justinkowski/flexrack-rails/README.md

# FlexRack Rail System
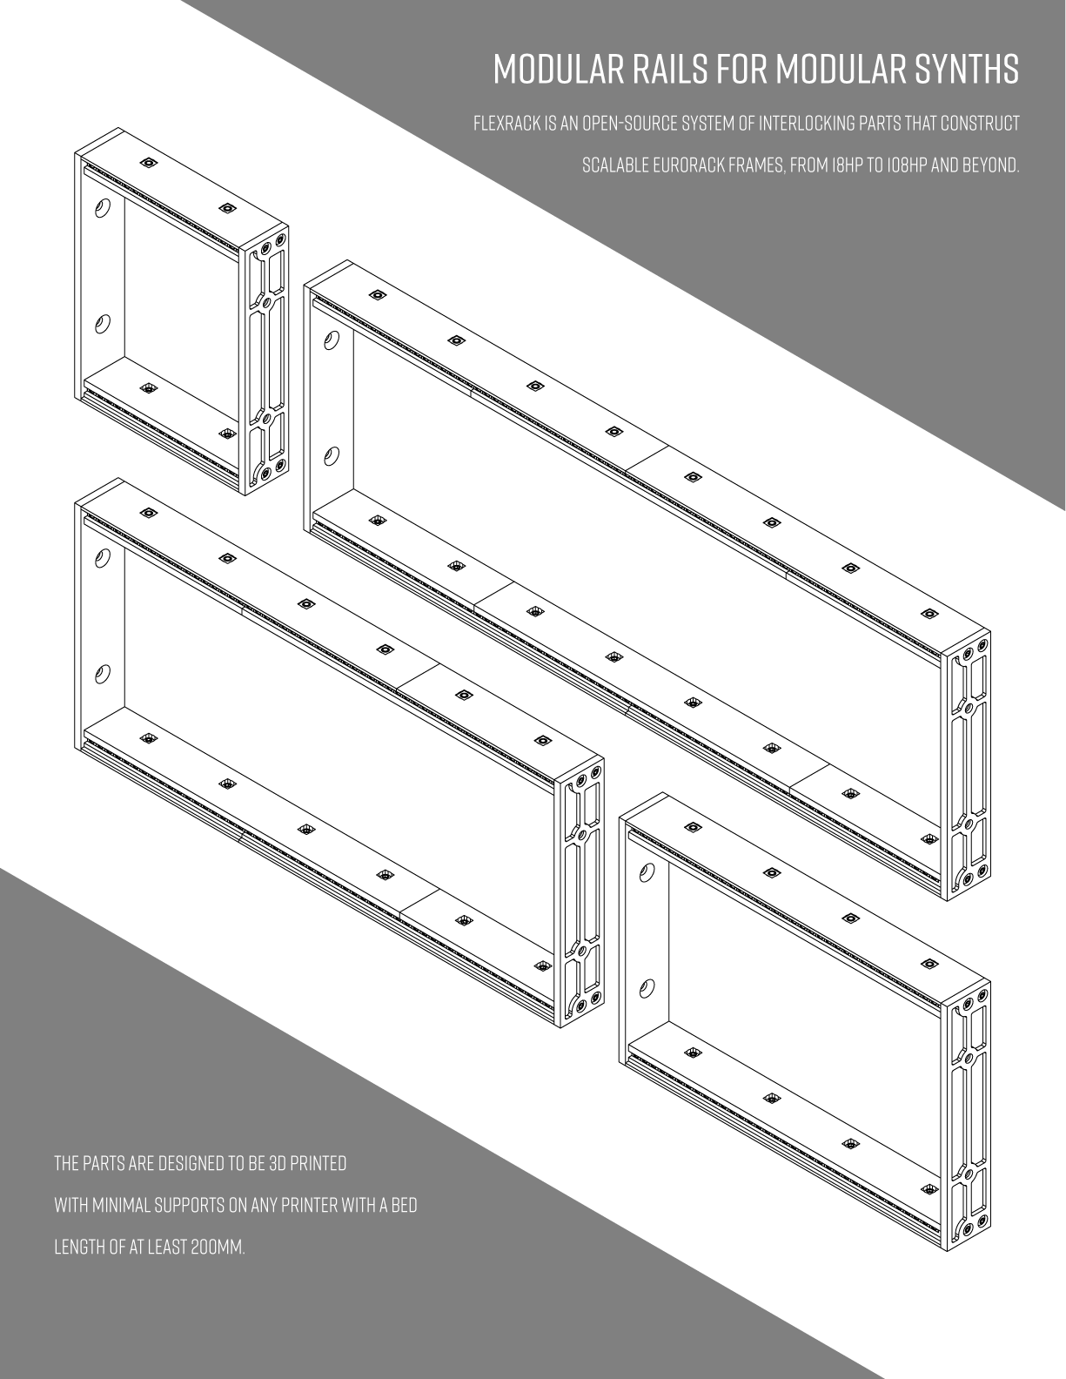
[picture p1: Images/01_intro.png]
FlexRack Intro

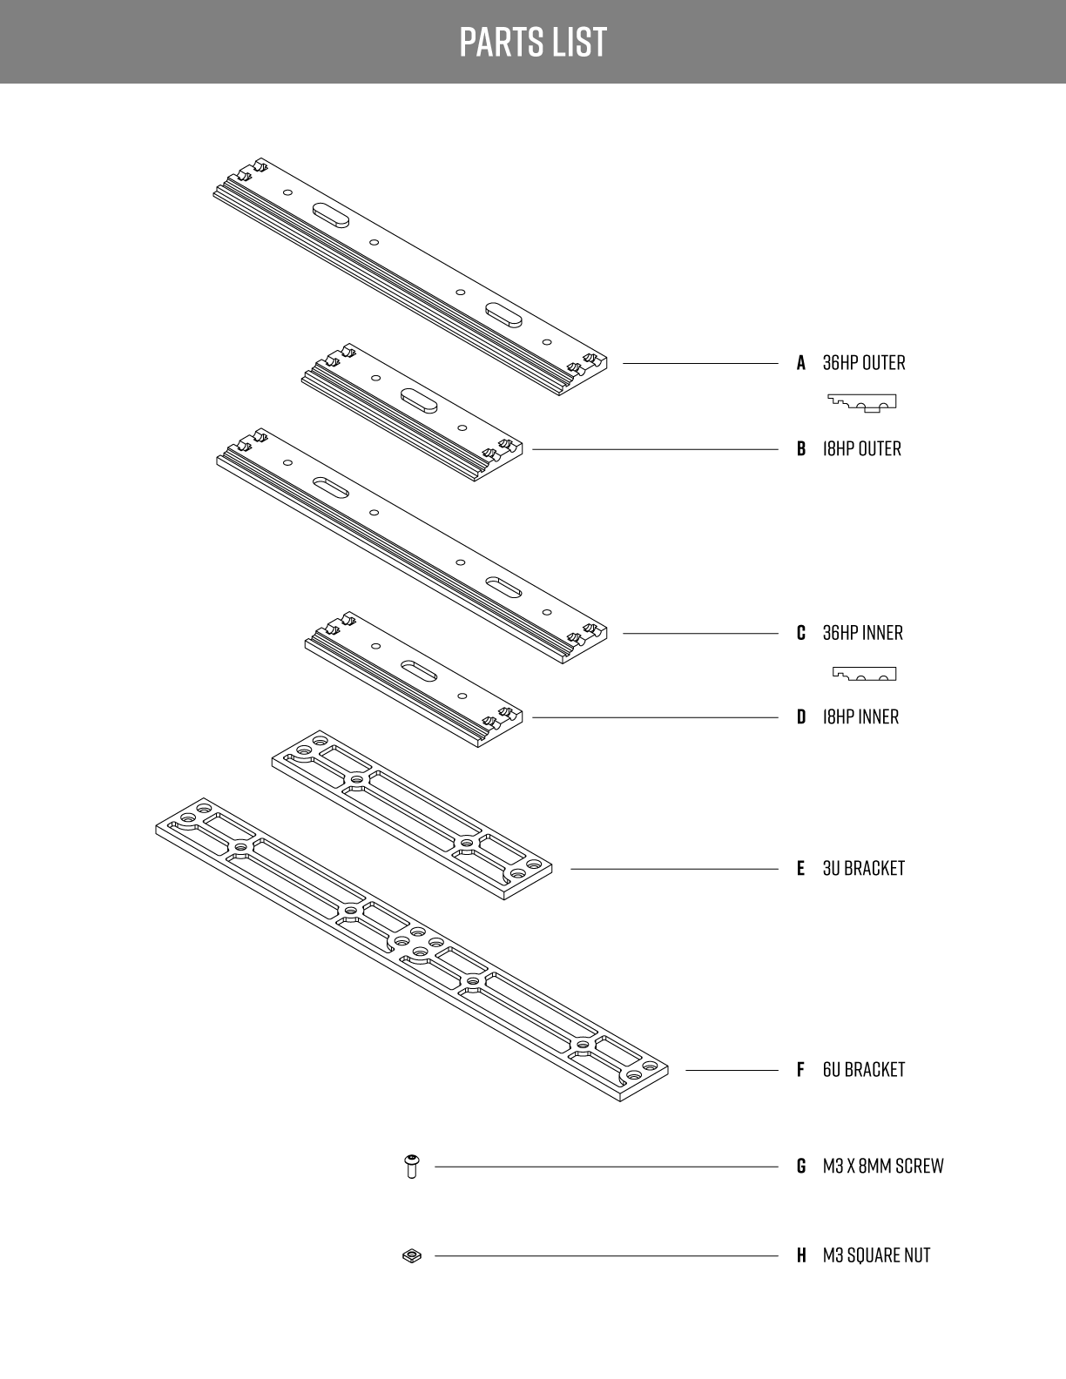
[picture p2: Images/02_parts.png]
Parts List

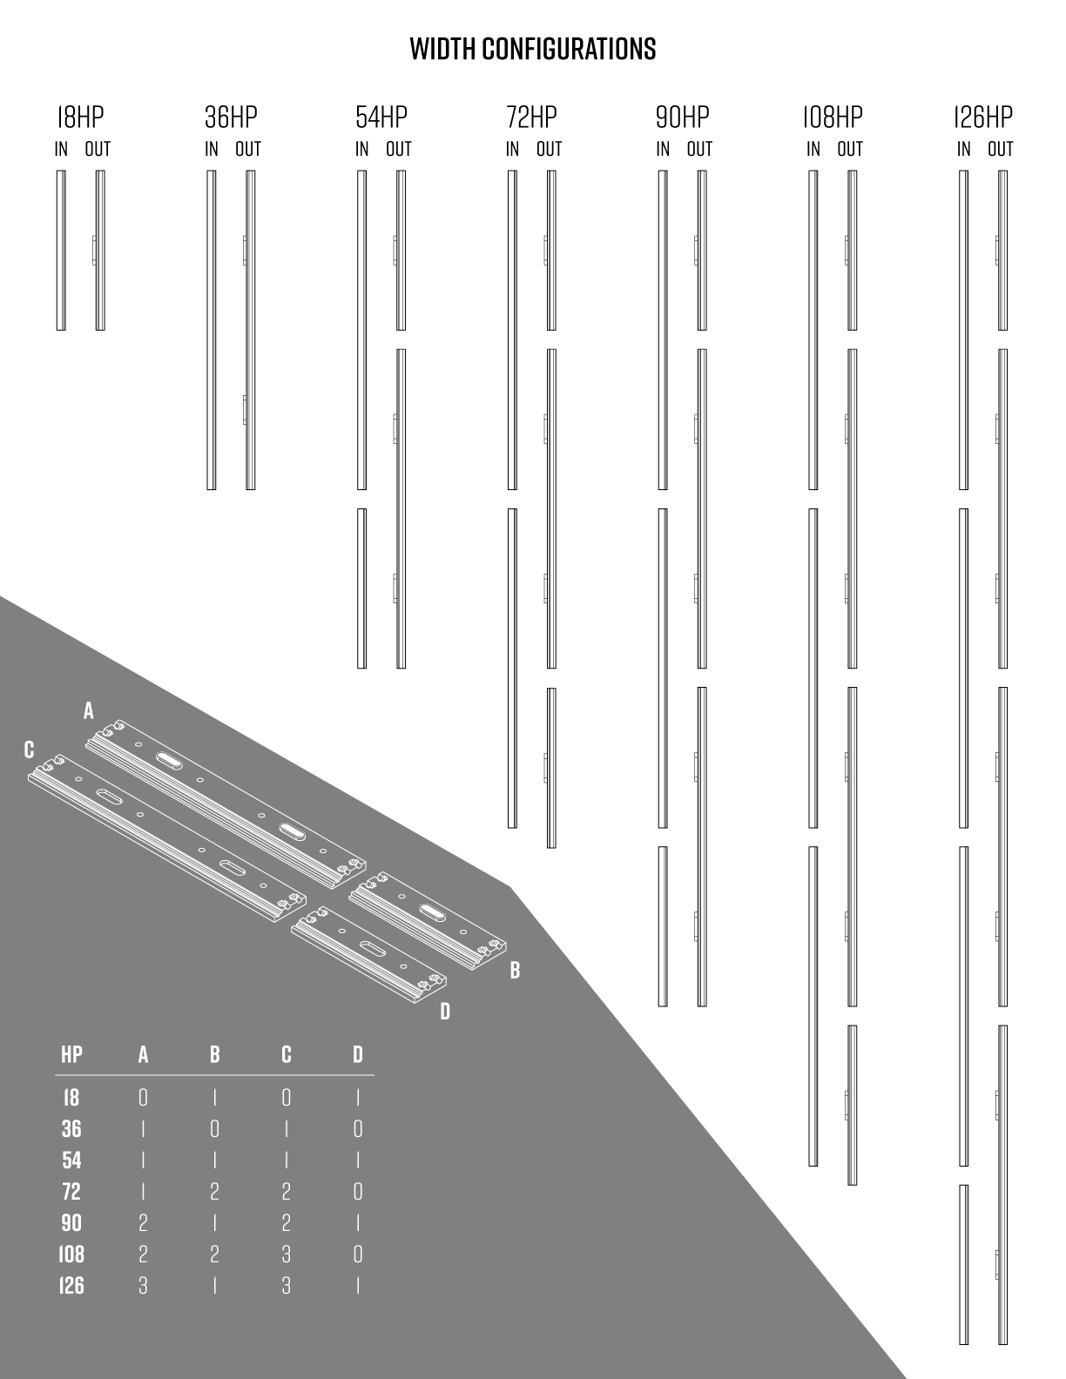
[picture p3: Images/03_width.png]
Width Configurations

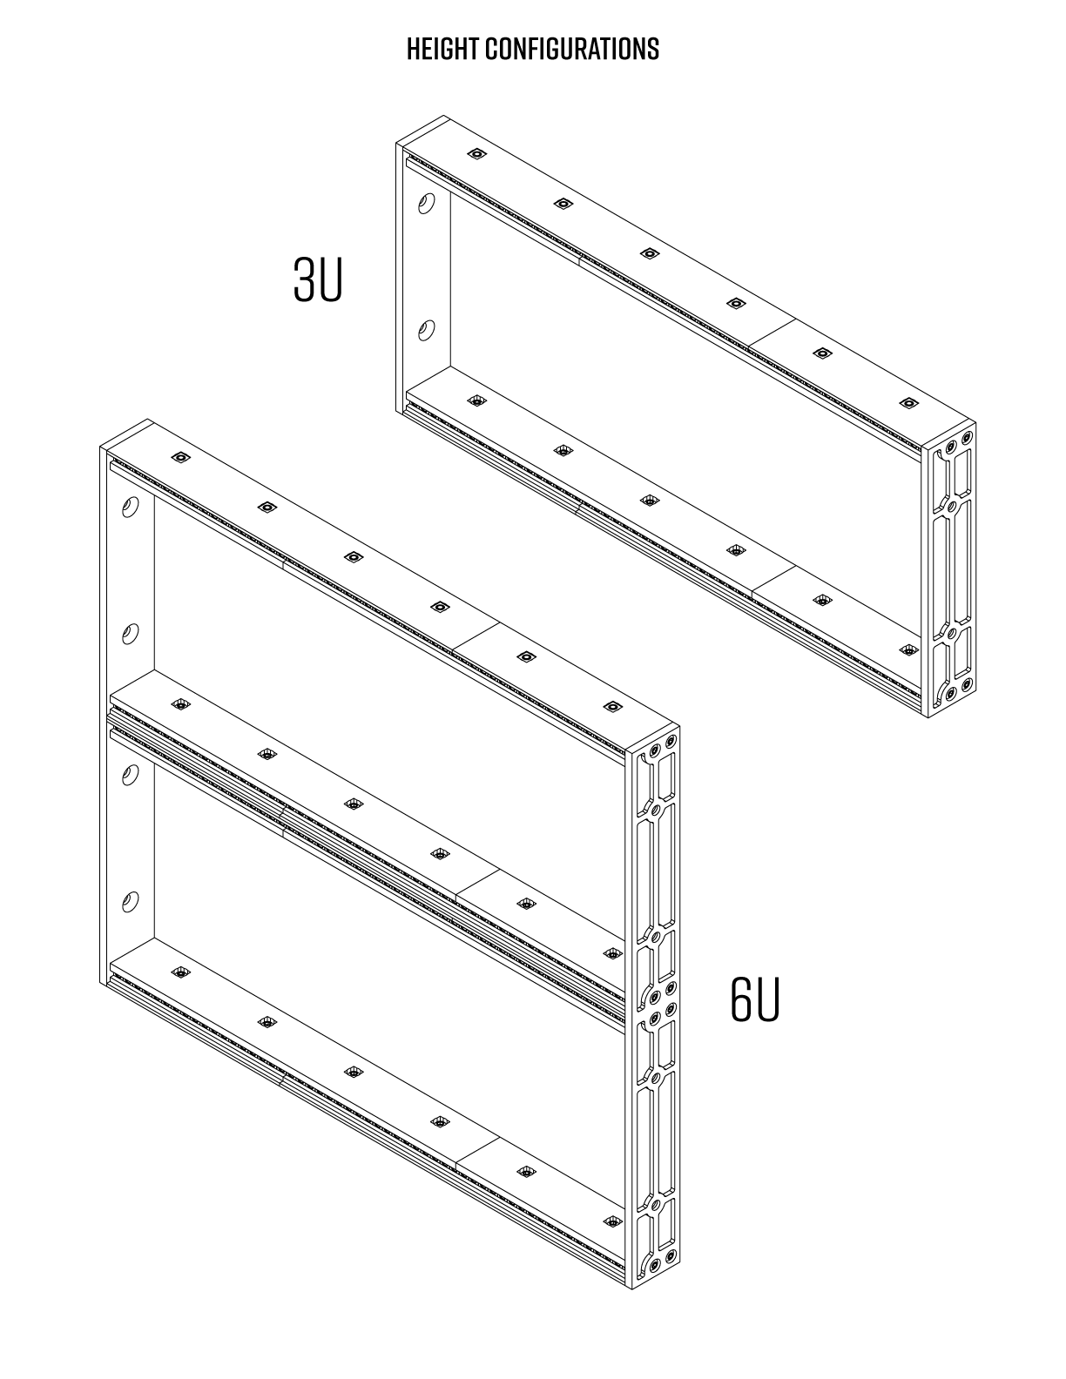
[picture p4: Images/04_height.png]
Height Configurations

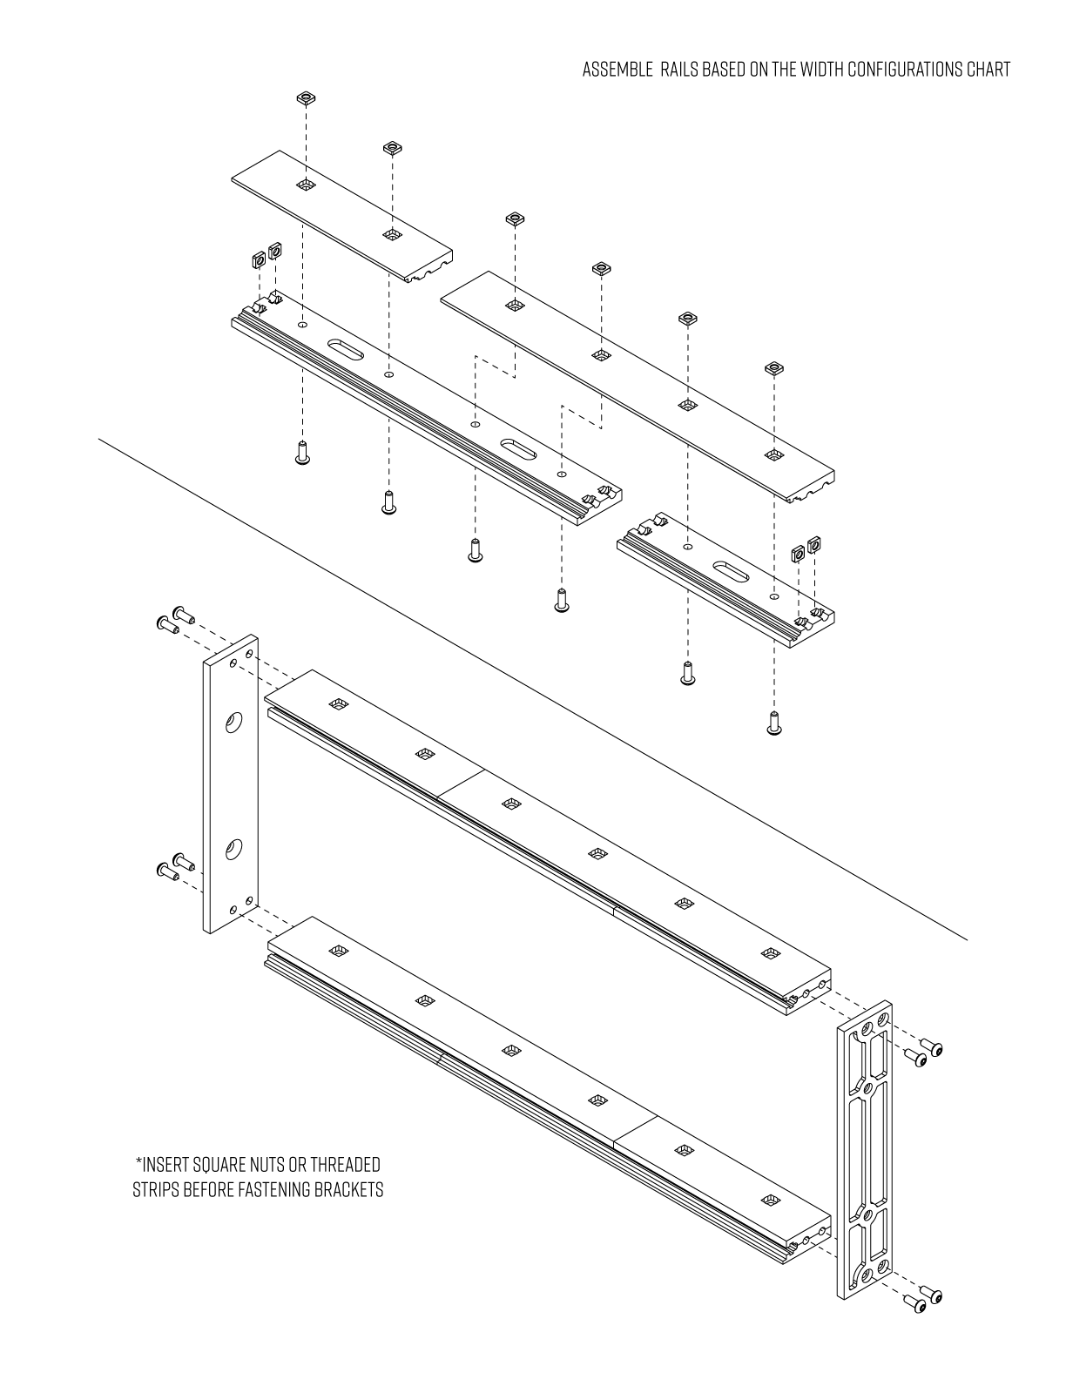
[picture p5: Images/05_asm.png]
FlexRack Assembly

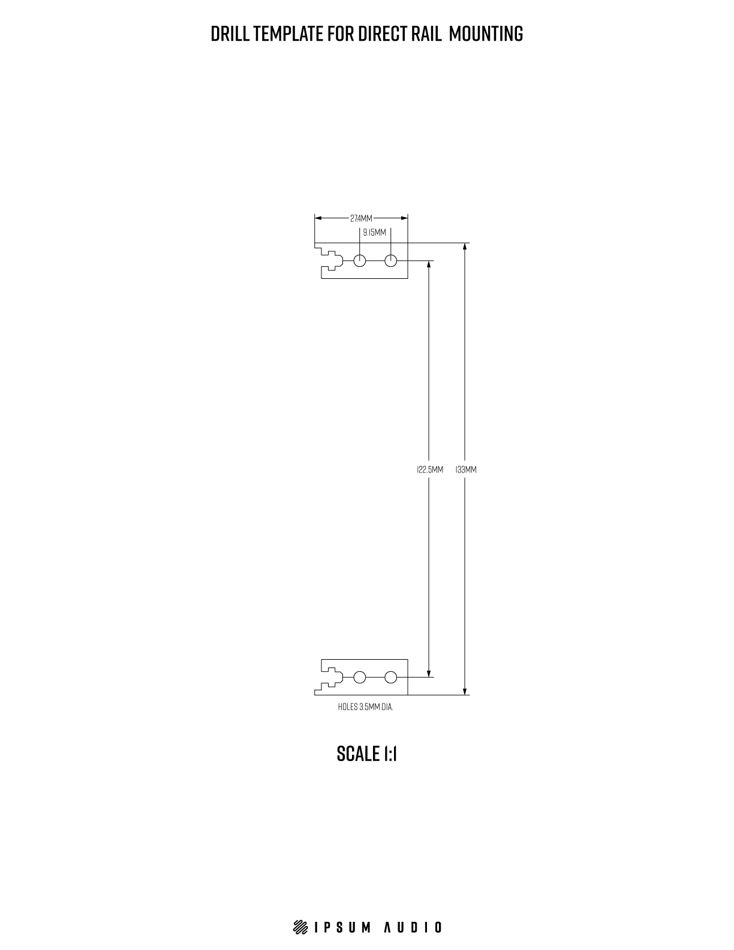
[picture p6: Images/06_drill.png]
Drill Template
