justinkowski/flexrack-rails/Images/00_cover.png

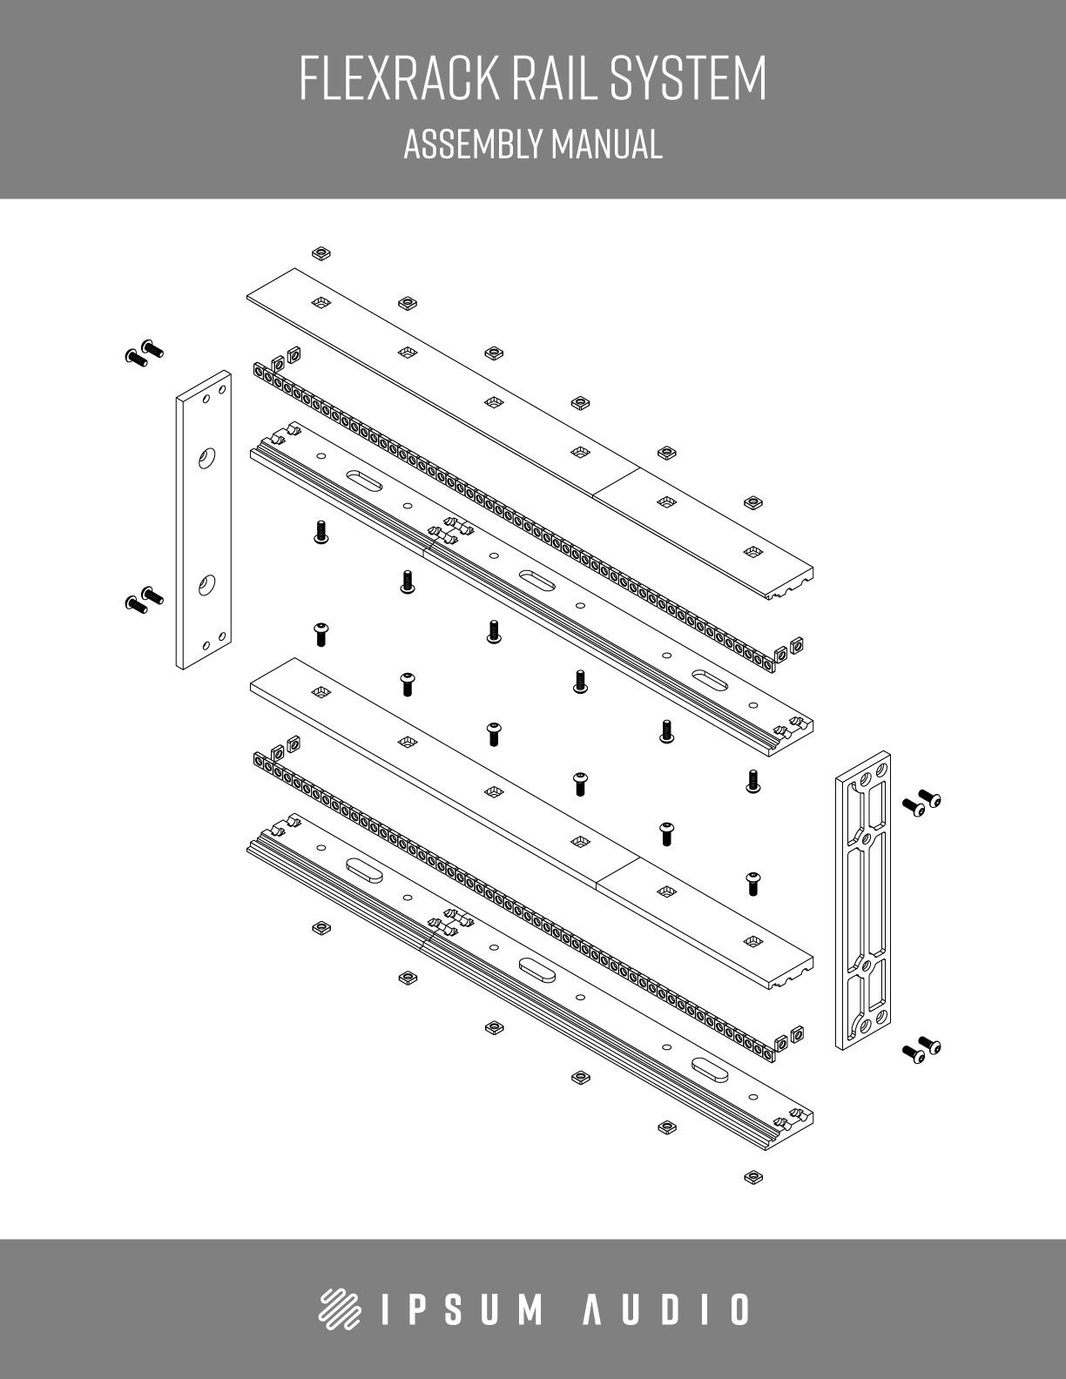
Images/00_cover.png
