justinkowski/flexrack-rails/3D/A_railOuter36.STEP

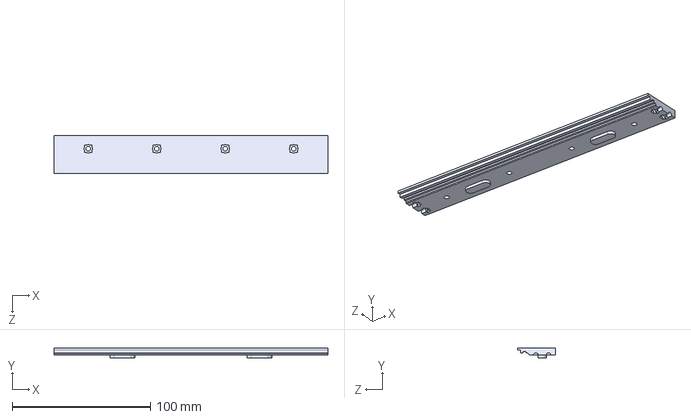
[picture p8: CAD file, 2020-10-18]
3D/A_railOuter36.STEP
198.0 x 7.25 x 27.4 mm
