justinkowski/flexrack-rails/3D/E_bracket3U.STEP

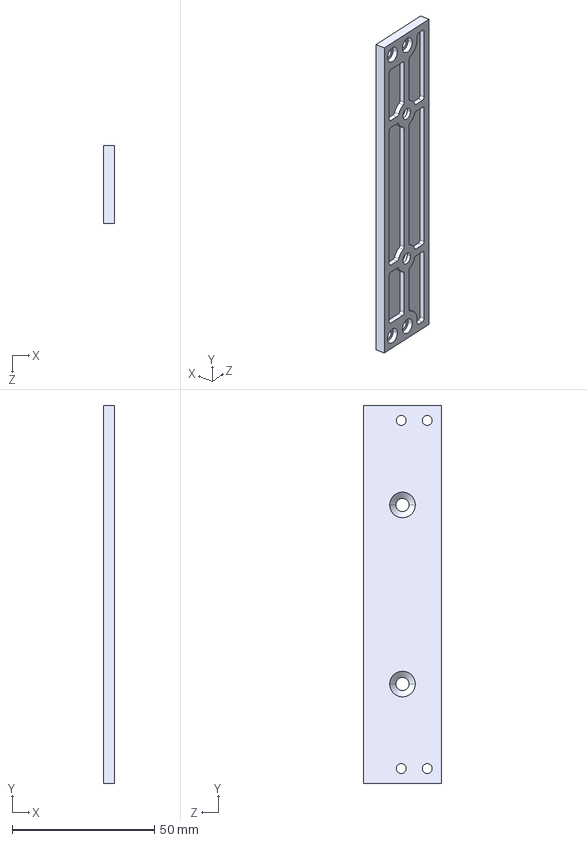
[picture p9: CAD file, 2020-10-18]
3D/E_bracket3U.STEP
4.00 x 133.0 x 27.4 mm
