justinkowski/flexrack-rails/3D/F_bracket6U.STEP

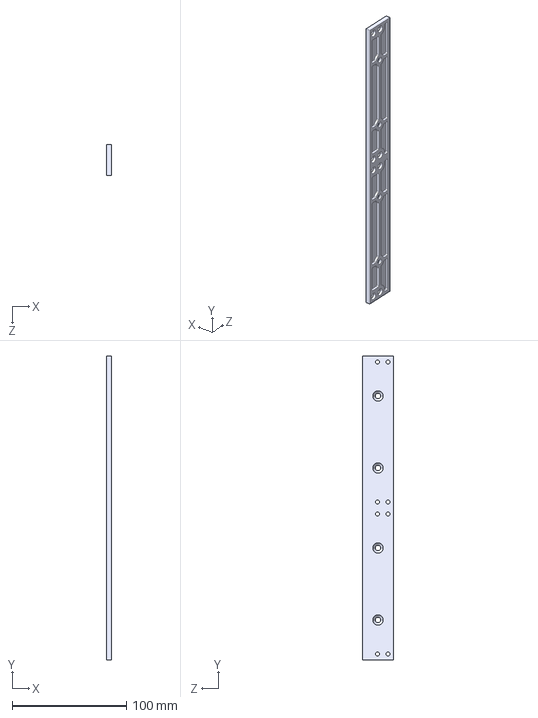
[picture p10: CAD file, 2020-10-18]
3D/F_bracket6U.STEP
4.00 x 266.0 x 27.4 mm
