justinkowski/flexrack-rails/3D/C_railInner36.STEP

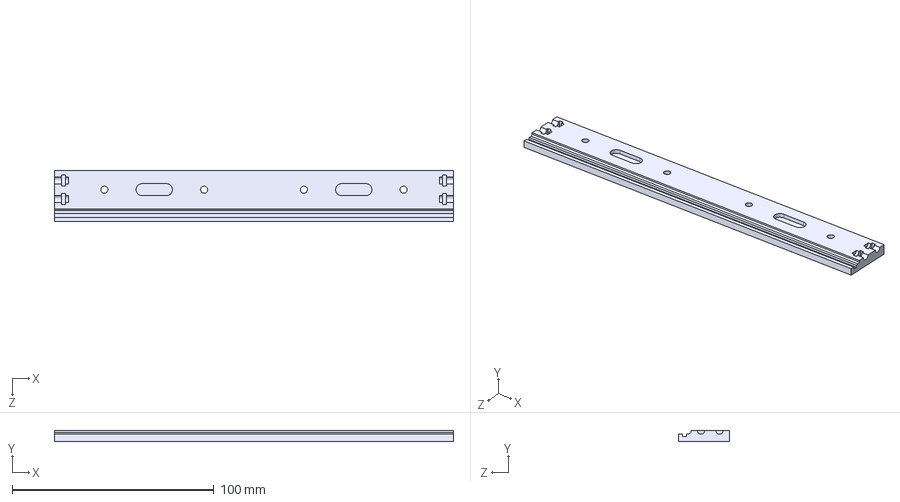
[picture p11: CAD file, 2020-10-18]
3D/C_railInner36.STEP
198.0 x 5.25 x 25.4 mm
