justinkowski/flexrack-rails/3D/D_railInner18.STEP

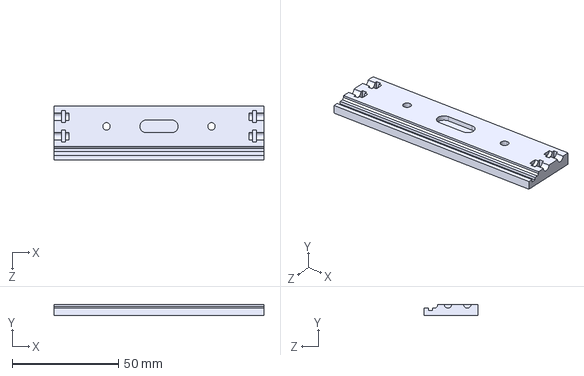
[picture p12: CAD file, 2020-10-18]
3D/D_railInner18.STEP
99.0 x 5.25 x 25.4 mm
