justinkowski/flexrack-rails/3D/B_railOuter18.STEP

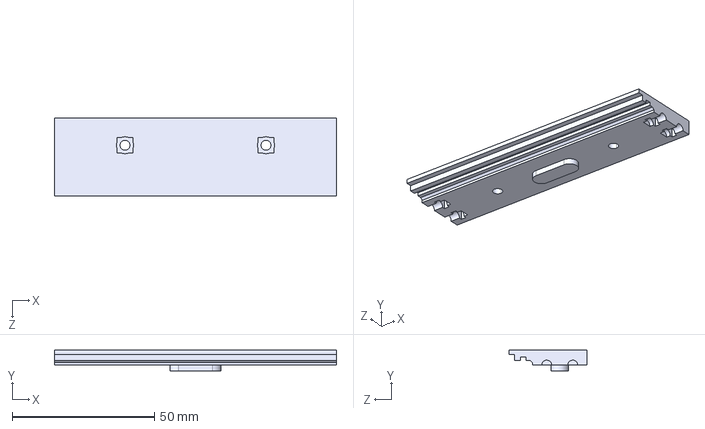
[picture p13: CAD file, 2020-10-18]
3D/B_railOuter18.STEP
99.0 x 7.25 x 27.4 mm
