justinkowski/flexrack-rails/(list of files, cad)

Other CAD files:
3D/A_railOuter36.STL
3D/B_railOuter18.STL
3D/C_railInner36.STL
3D/D_railInner18.STL
3D/E_bracket3U.STL
3D/F_bracket6U.STL
