justinkowski/flexrack-rails/PDF Manual/FlexRack Manual.pdf

# FlexRack Rail System

# assembly MANUAL

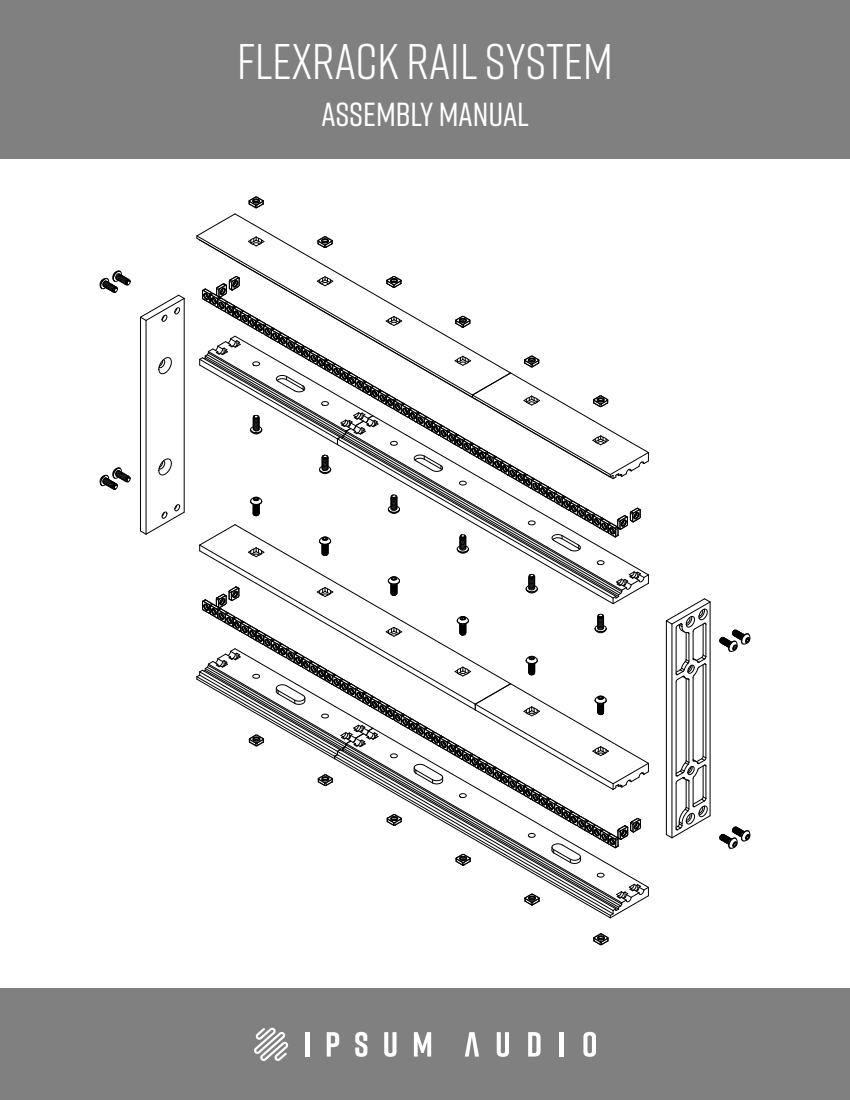
[picture p14: page 1]

# Modular Rails for Modular synths

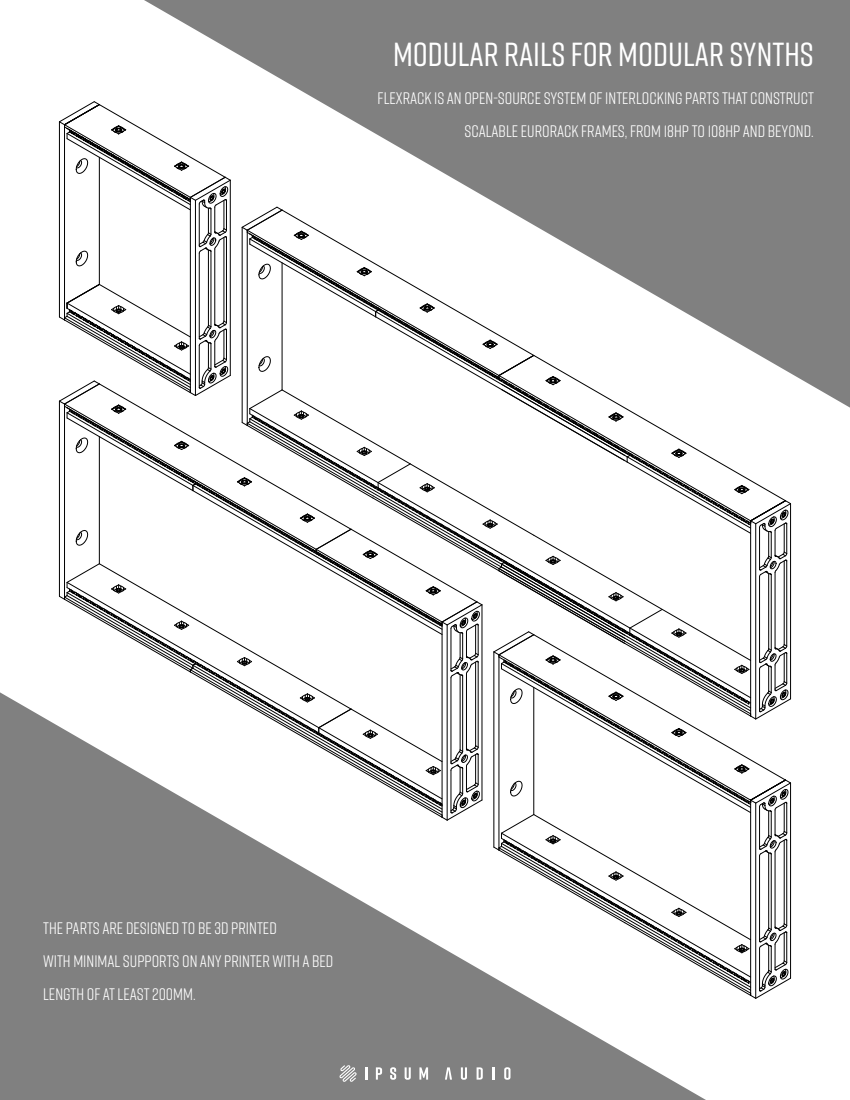
[picture p15: page 2]

FlexRack is an open-source system of interlocking parts that construct

scalable Eurorack frames, from 18HP to 108HP and beyond.

The parts are designed to be 3D printed
with minimal supports on any printer with a bed
length of at least 200mm.

# PARTS LIST

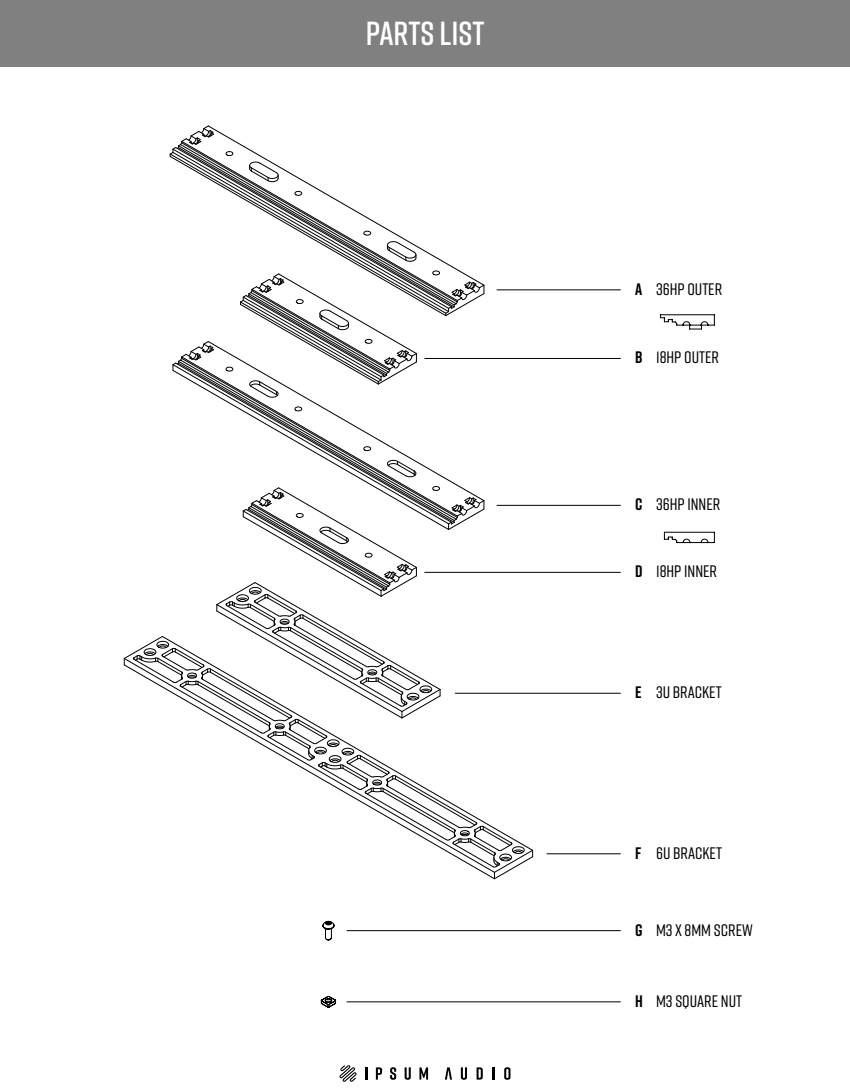
[picture p16: page 3]
36HP outer; 18HP outer; 36HP inner; 18HP inner; 3U BRACKET; 6U BRACKET; M3 X 8MM SCREW; M3 SQUARE NUT

18HP | 36HP | 54HP | 72HP | 90HP | 108HP | 126HP

## width configurations

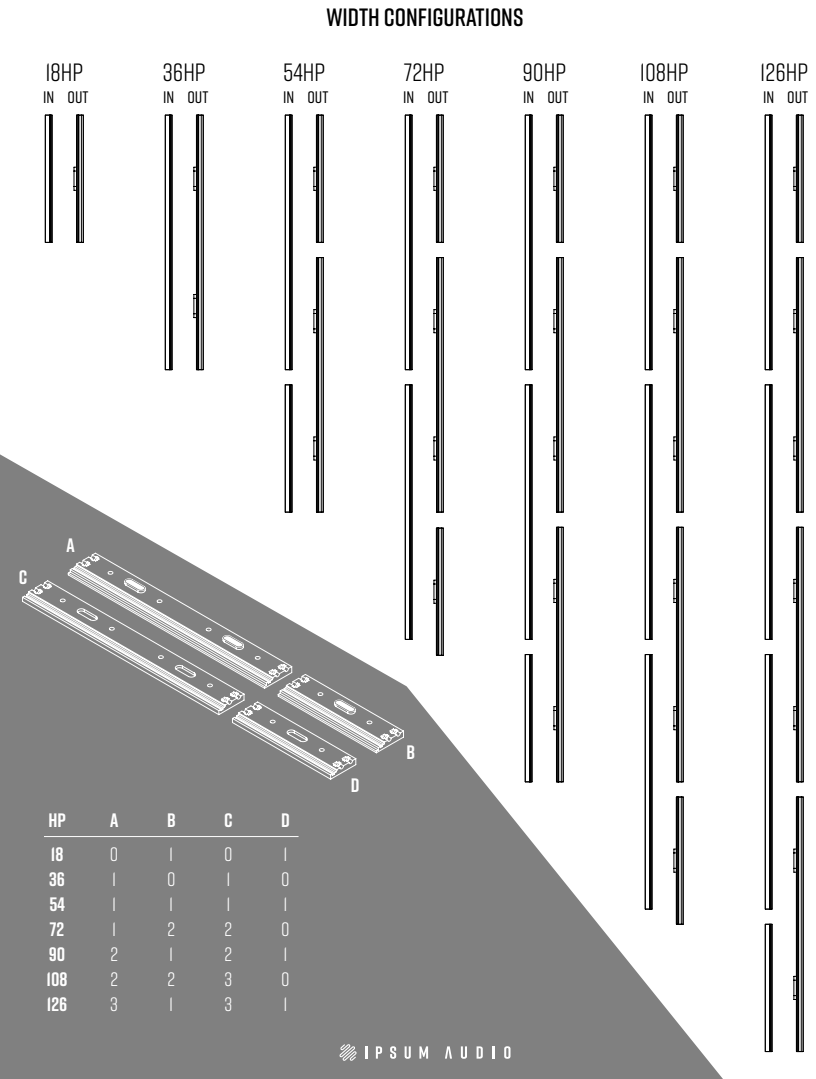
[picture p17: page 4]
in out

3U

## height configurations

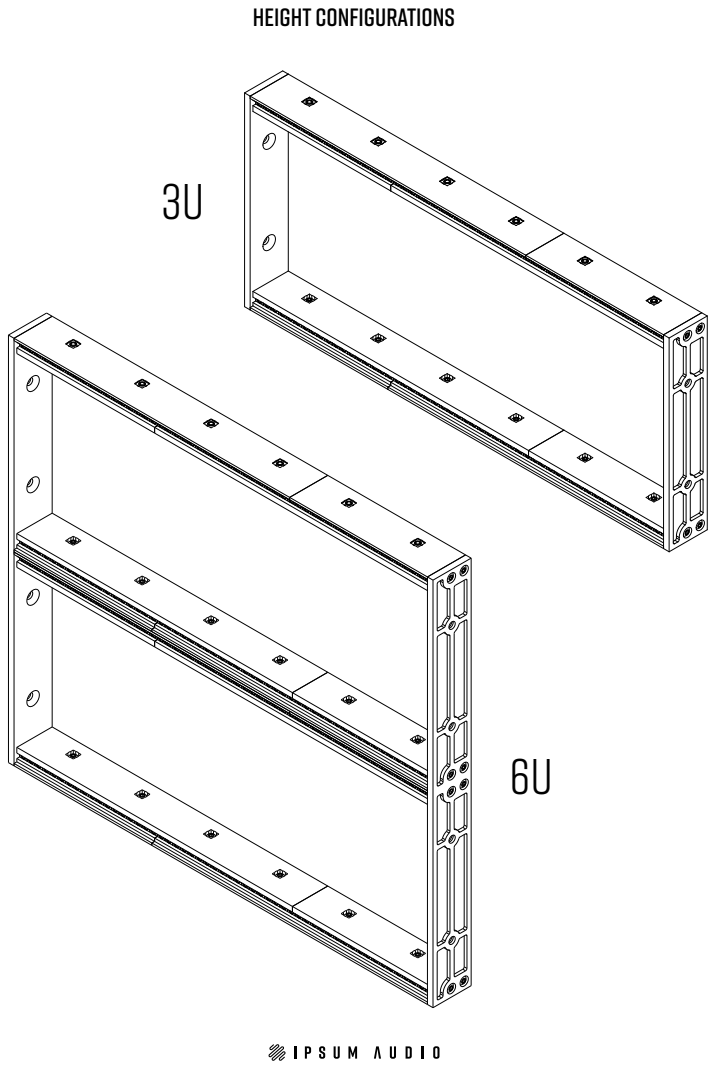
[picture p18: page 5]

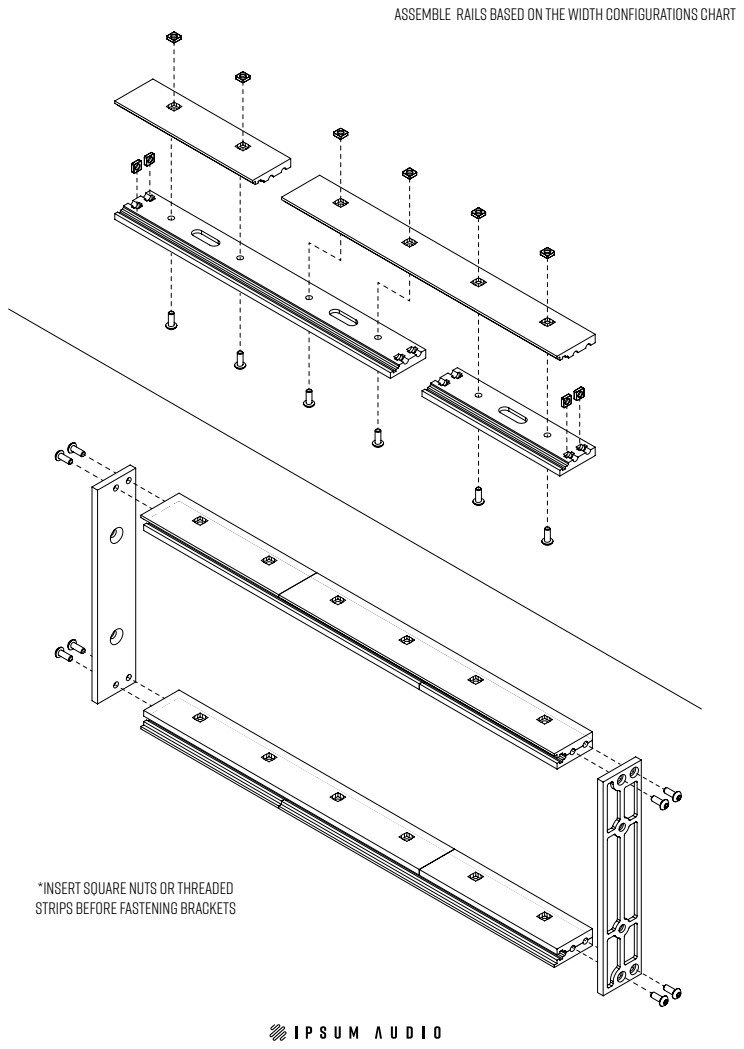
[picture p19: page 6]

assemble rails based on the width configurations chart

*insert square nuts or threaded
strips before fastening brackets

## drill template for direct rail mounting

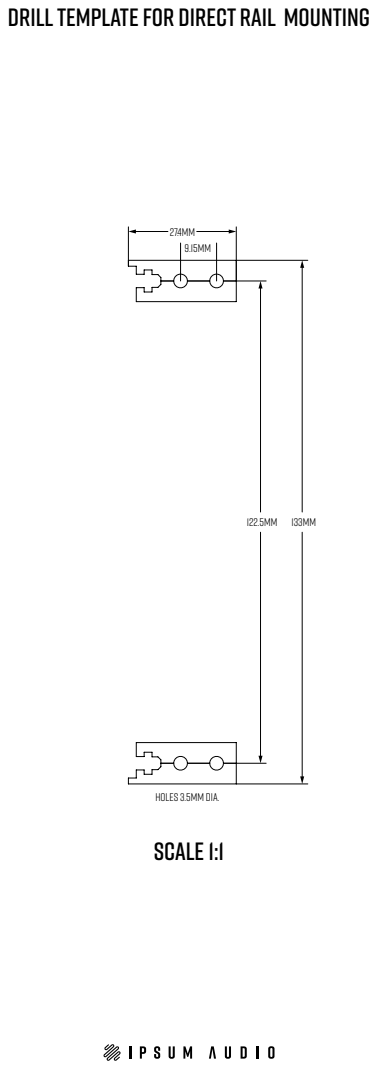
[picture p20: page 7]
holes 3.5mm dia.; Scale 1:1
