justinkowski/flexrack-rails/(threads)

Thread 4 (2020-10-29):

Standardized rail formats

erik404, 2020-10-29:
Hi, first of all; thank you for your works! This is great progress in the world of DIY modular.

I have to ask though, what is the reason why you did not use the standardized rail formats (84, 104, 114, etc), and is it possible to adjust these designs to that width?

justinkowski, 2020-10-29:
Hi, thanks for the feedback!

I wanted to use the standard rail lengths, but I also wanted to have just one set of bricks to print. Since there is no common denominator between the usual sizes, 18/36HP seemed like a good compromise as it can achieve 72/90/108HP which are close.

However, I've had some other requests for at least 84HP and 104HP lengths to accommodate those laser cut cases, so I will probably put together files that are tailored to those specifically. I will update the files and close this issue if/when I get to it!

erik404, 2020-10-29:
Great! Thanks for your reply!

websherpa, 2024-11-07:
This is a great design, and I assume this may not get more attention, but a standard 84HP would be a great addition, thank you!

Thread 5 (2022-01-12):

54hp is actually 58.5hp?

risro, 2022-01-12:
I just printed and measured the 54hp rail and got 297mm?

(297mm to inch)/0.2 = 58.5hp?

(also fusion 360 measured the same with the .step parts)

kind of sucks because i already measured everything assuming it was 54hp (27.43cm) so... starting over i guess

triss, 2024-09-06:
It'd be wonderful if some working box dimensions could be added to the documentation for the configurations!

dehuszar, 2024-12-30:
I [took a swing](https://github.com/justinkowski/flexrack-rails/pull/8) at fixing the rail segment widths.  So far so good.  I've printed out the rails and they measure correctly.
